erinjense/raspberrypi-indoor-air-quality-pcb/README.md

# zephyrus-iaq
Hardware and Software for an Indoor Air Quality Logger

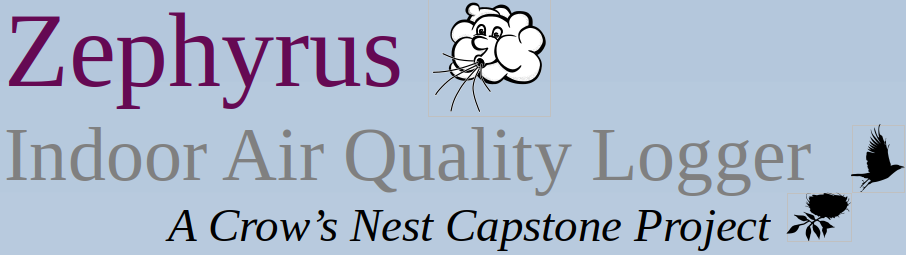
[picture p1: Software/images/Zephyrus-IAQ-Logo.png]

More to come...
