erinjense/raspberrypi-indoor-air-quality-pcb/Hardware/Pictures/Crows-Nest-CC.png

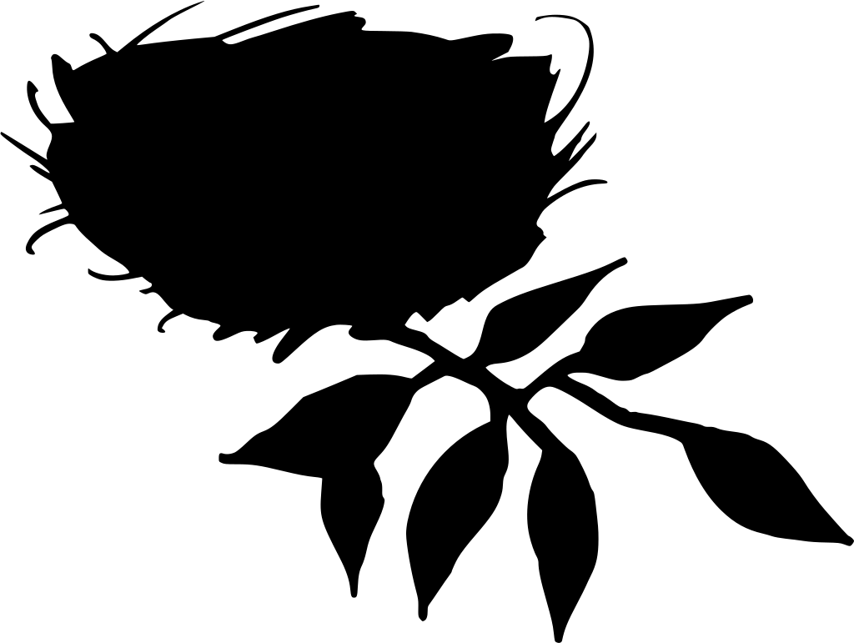
Hardware/Pictures/Crows-Nest-CC.png
