erinjense/raspberrypi-indoor-air-quality-pcb/Hardware/Pictures/Flying-Crow-CC.png

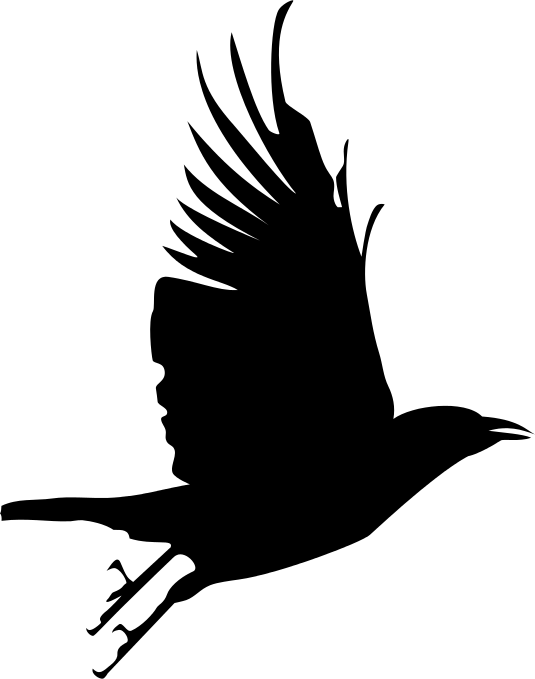
Hardware/Pictures/Flying-Crow-CC.png
