erinjense/raspberrypi-indoor-air-quality-pcb/Software/Config/logger_setup.csv

Logger Type | IAQ
Id | IAQ_0
Software Version | Alpha
Headers | Date(YYYY/MM/DD) | Time(HH:MM:SS) | Location(degrees) | Temp(C) | Humidity(RH)
Sensors | ./config/sensors/bme680.csv | ./config/sensors/mq_gas.csv
