erinjense/raspberrypi-indoor-air-quality-pcb/Hardware/Zephyrus-IAQ-HAT.pdf

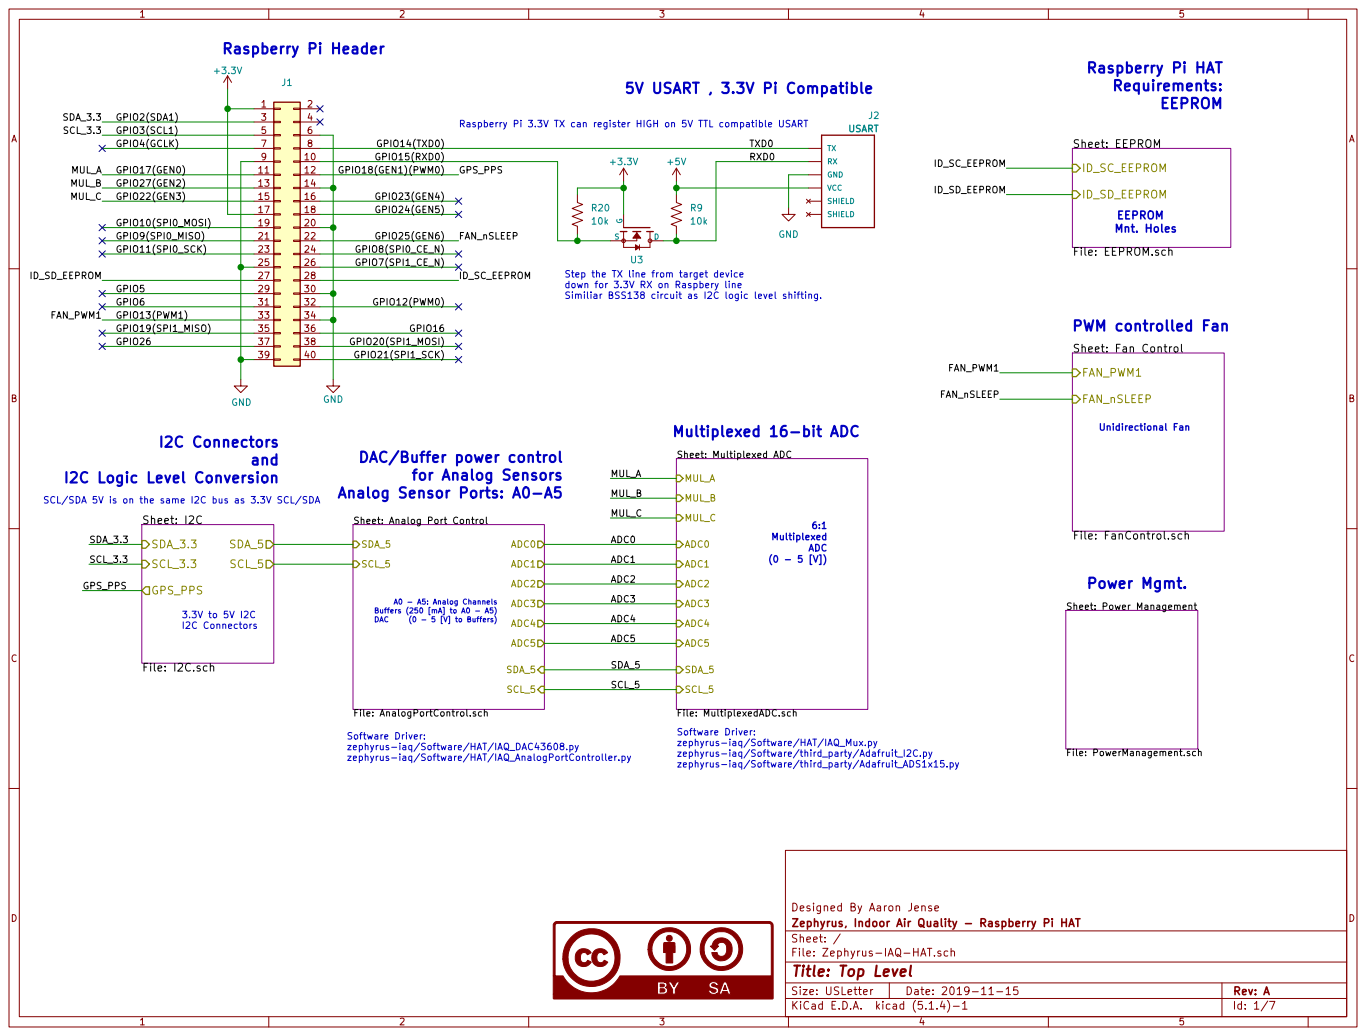
[picture p4: page 1]

Raspberry Pi 3.3V TX can register HIGH on 5V TTL compatible USART

9 | | 10 | GPIO15(RXD0)
11 | | 12 | GPIO18(GEN1)(PWM0)
13 | | 14 | GPIO23(GEN4)
15 | | 16
17 | | 18 | GPIO24(GEN5)
19 | | 20 | GPIO25(GEN6)
21 | | 22
23 | | 24
25 | | 26
27 | | 28
29 | | 30
31 | | 32
33 | | 34
35 | | 36
37 | | 38
39 | | 40

Step the TX line from target device
down for 3.3V RX on Raspbery line
File: MultiplexedADC.sch ADC0 ADC1 ADC2 ADC3 ADC4 ADC5 MUL_A MUL_B MUL_C

DAC/Buffer power control
for Analog Sensors

Designed By Aaron Jense Sheet: I2C

Sheet: Analog Port Control

Software Driver: zephyrus-iaq/Software/HAT/IAQ_Mux.py

zephyrus-iaq/Software/third_party/Adafruit_ADS1x15.py Software Driver: zephyrus-iaq/Software/HAT/IAQ_DAC43608.py

zephyrus-iaq/Software/HAT/IAQ_AnalogPortController.py

zephyrus-iaq/Software/third_party/Adafruit_I2C.py

File: Zephyrus-IAQ-HAT.sch Sheet: / Zephyrus, Indoor Air Quality - Raspberry Pi HAT

Id: 1/7 Title: Top Level

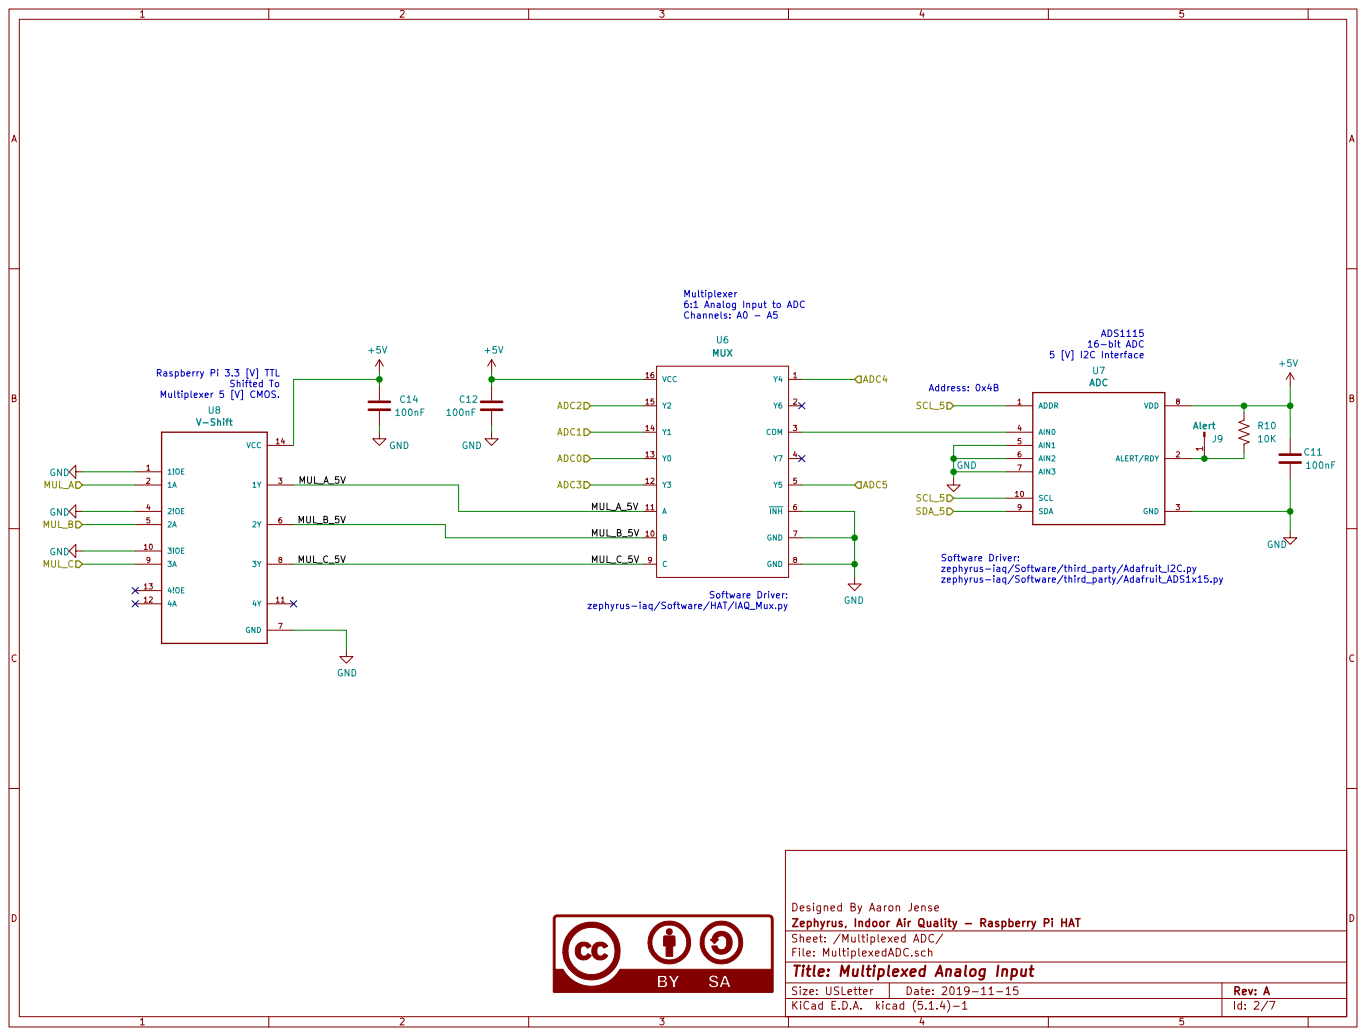
[picture p5: page 2]

Multiplexer
6:1 Analog Input to ADC

Channels: A0 - A5 Raspberry Pi 3.3 [V] TTL Shifted To

zephyrus-iaq/Software/third_party/Adafruit_ADS1x15.py Address: 0x4B

Designed By Aaron Jense
Zephyrus, Indoor Air Quality - Raspberry Pi HAT
Sheet: /Multiplexed ADC/
File: MultiplexedADC.sch
Id: 2/7 Title: Multiplexed Analog Input

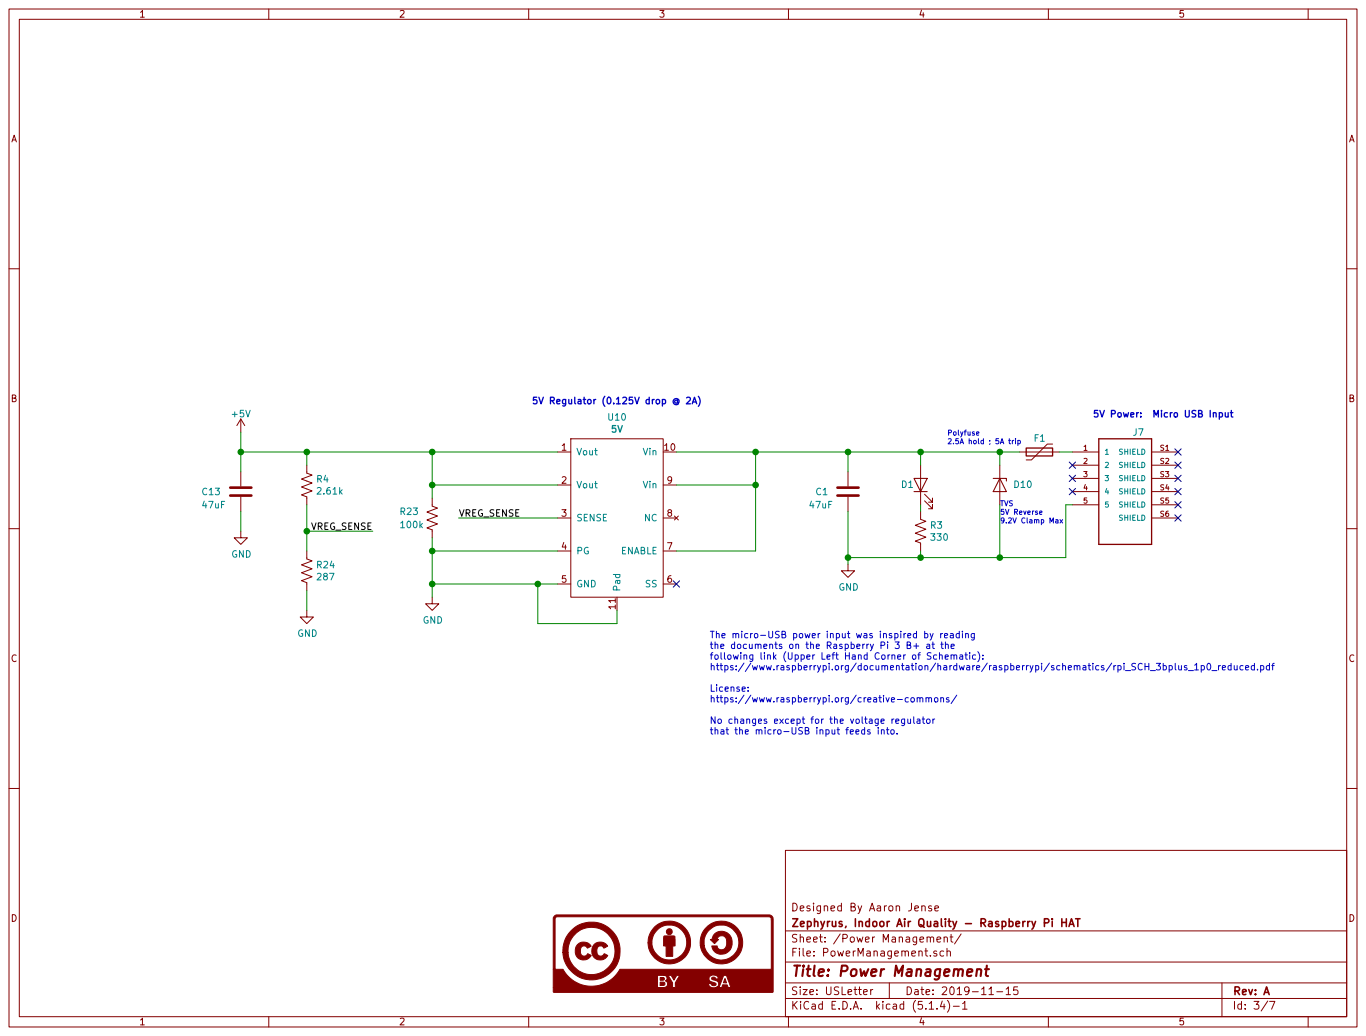
[picture p6: page 3]

2.5A hold ; 5A trip 5V Regulator (0.125V drop @ 2A)

5V Power: Micro USB Input TVS

The micro-USB power input was inspired by reading
the documents on the Raspberry Pi 3 B+ at the
following link (Upper Left Hand Corner of Schematic):
https://www.raspberrypi.org/documentation/hardware/raspberrypi/schematics/rpi_SCH_3bplus_1p0_reduced.pdf License: https://www.raspberrypi.org/creative-commons/

No changes except for the voltage regulator
that the micro-USB input feeds into.

Designed By Aaron Jense
Zephyrus, Indoor Air Quality - Raspberry Pi HAT
Sheet: /Power Management/
File: PowerManagement.sch
Id: 3/7 Title: Power Management

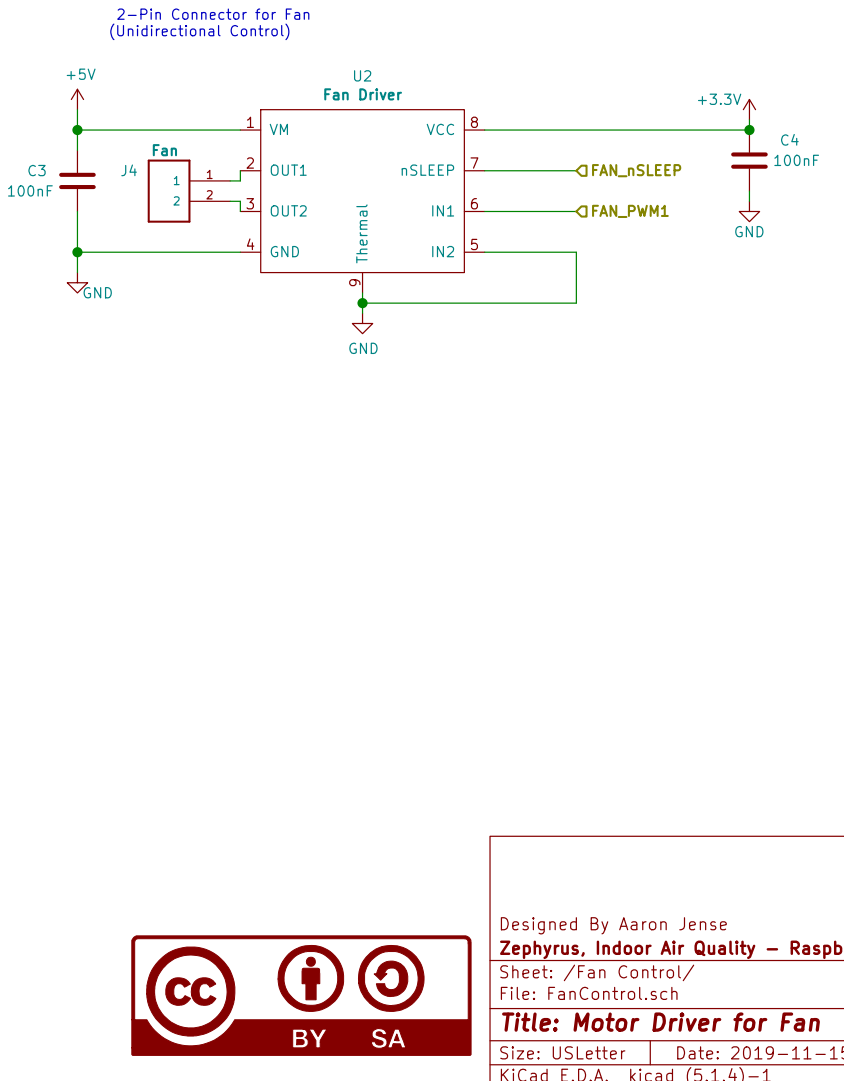
[picture p7: page 4]

2-Pin Connector for Fan
(Unidirectional Control)

Designed By Aaron Jense
File: FanControl.sch Sheet: /Fan Control/ Zephyrus, Indoor Air Quality - Raspberry Pi HAT

Id: 4/7 Title: Motor Driver for Fan

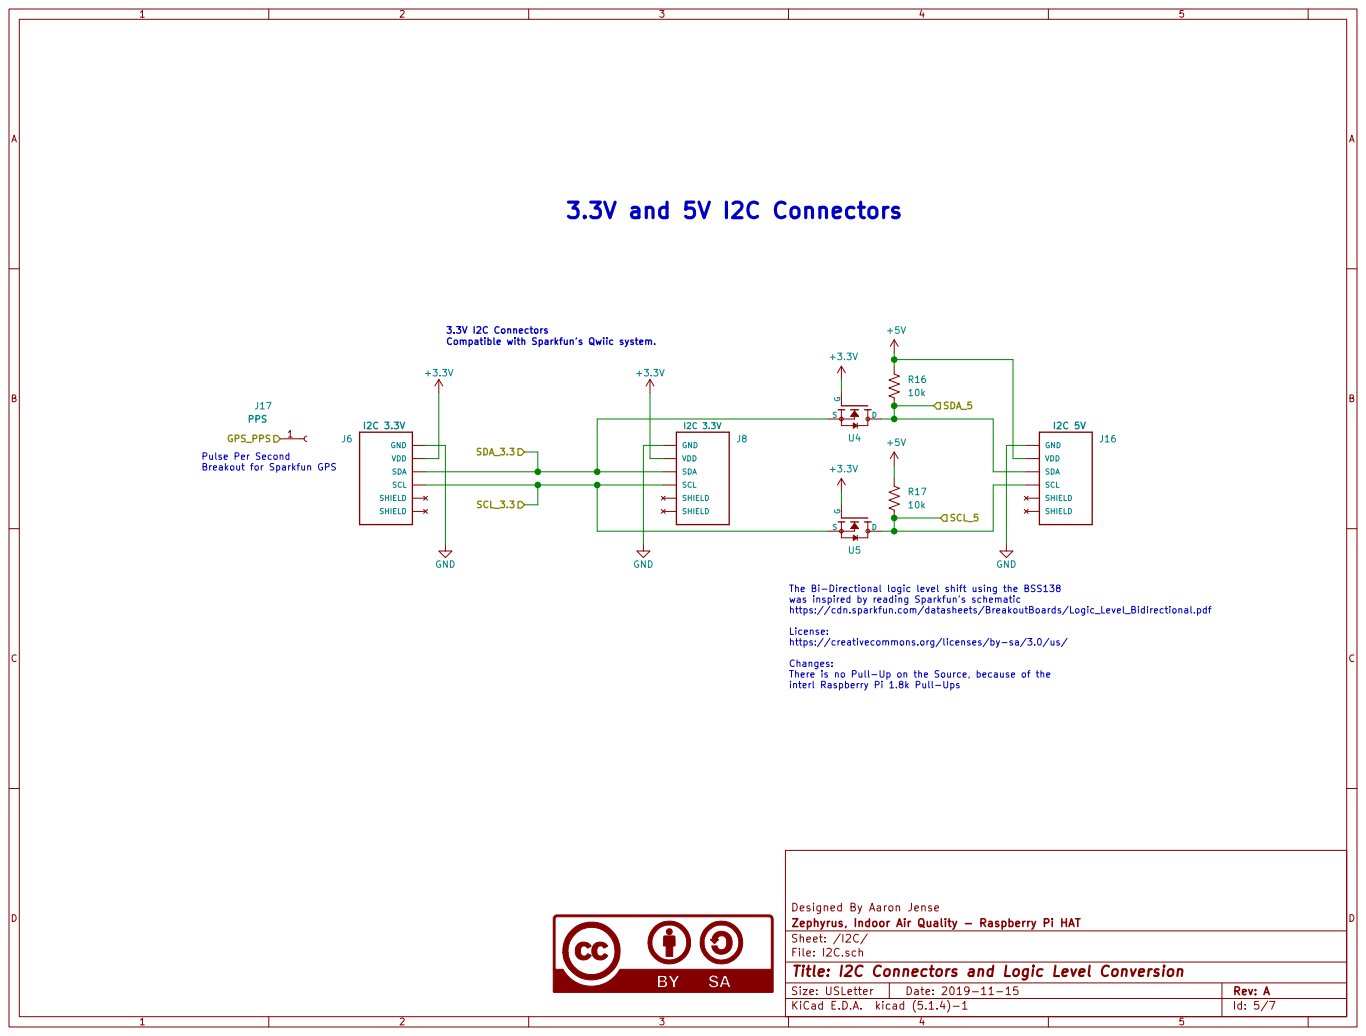
[picture p8: page 5]

interl Raspberry Pi 1.8k Pull-Ups 3.3V I2C Connectors Compatible with Sparkfun's Qwiic system.

SCL_3.3 SDA_3.3 Pulse Per Second Breakout for Sparkfun GPS

The Bi-Directional logic level shift using the BSS138
was inspired by reading Sparkfun's schematic
https://cdn.sparkfun.com/datasheets/BreakoutBoards/Logic_Level_Bidirectional.pdf License: https://creativecommons.org/licenses/by-sa/3.0/us/

Changes:
There is no Pull-Up on the Source, because of the

Designed By Aaron Jense
File: I2C.sch Sheet: /I2C/ Zephyrus, Indoor Air Quality - Raspberry Pi HAT

Id: 5/7 Title: I2C Connectors and Logic Level Conversion

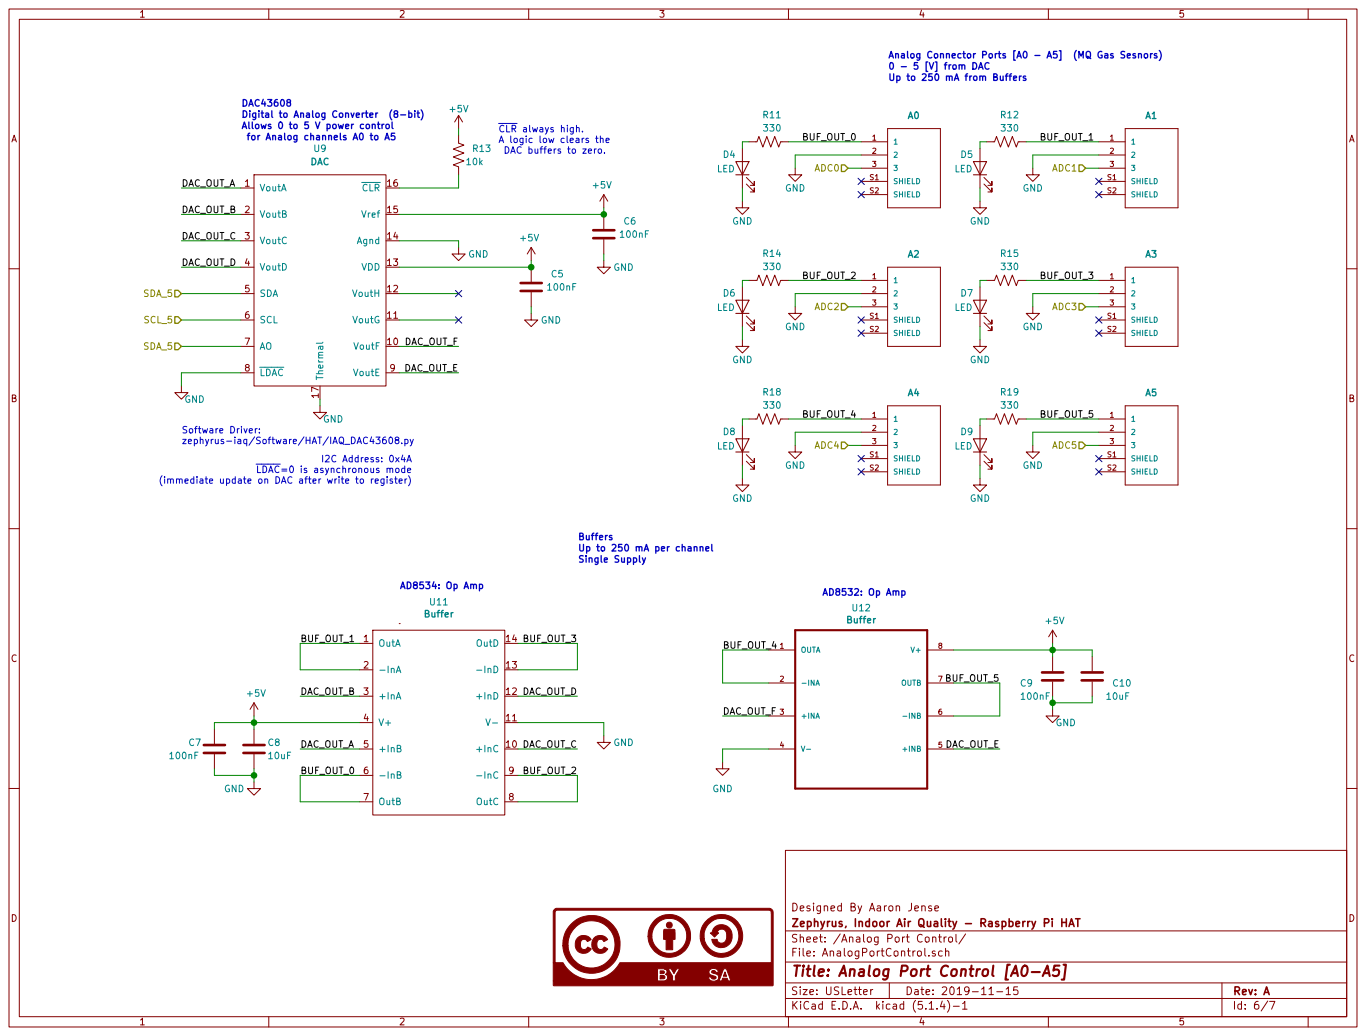
[picture p9: page 6]

Analog Connector Ports [A0 - A5] (MQ Gas Sesnors)
0 - 5 [V] from DAC

Up to 250 mA from Buffers DAC43608 Digital to Analog Converter (8-bit)

Allows 0 to 5 V power control
for Analog channels A0 to A5

CLR always high.
A logic low clears the

(immediate update on DAC after write to register)

LDAC=0 is asynchronous mode

Designed By Aaron Jense
Zephyrus, Indoor Air Quality - Raspberry Pi HAT
Sheet: /Analog Port Control/
File: AnalogPortControl.sch
Id: 6/7 Title: Analog Port Control [A0-A5]

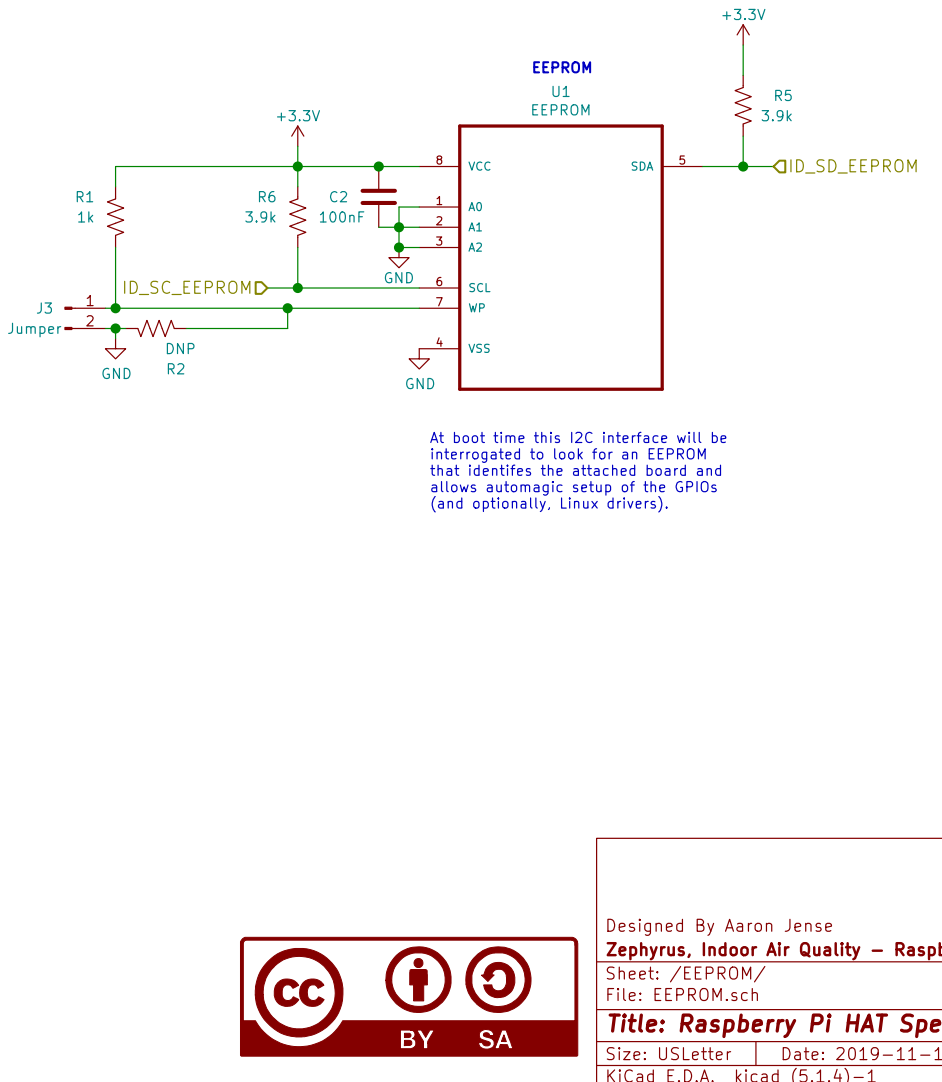
[picture p10: page 7]

Designed By Aaron Jense GND

At boot time this I2C interface will be
interrogated to look for an EEPROM
that identifes the attached board and
allows automagic setup of the GPIOs
(and optionally, Linux drivers).

File: EEPROM.sch Sheet: /EEPROM/ Zephyrus, Indoor Air Quality - Raspberry Pi HAT

Id: 7/7 Title: Raspberry Pi HAT Specifications
