erinjense/raspberrypi-indoor-air-quality-pcb/Hardware/Zephyrus-IAQ-HAT.kicad_pcb

## KiCad design Hardware/Zephyrus-IAQ-HAT.kicad_pcb (2019-12-04)

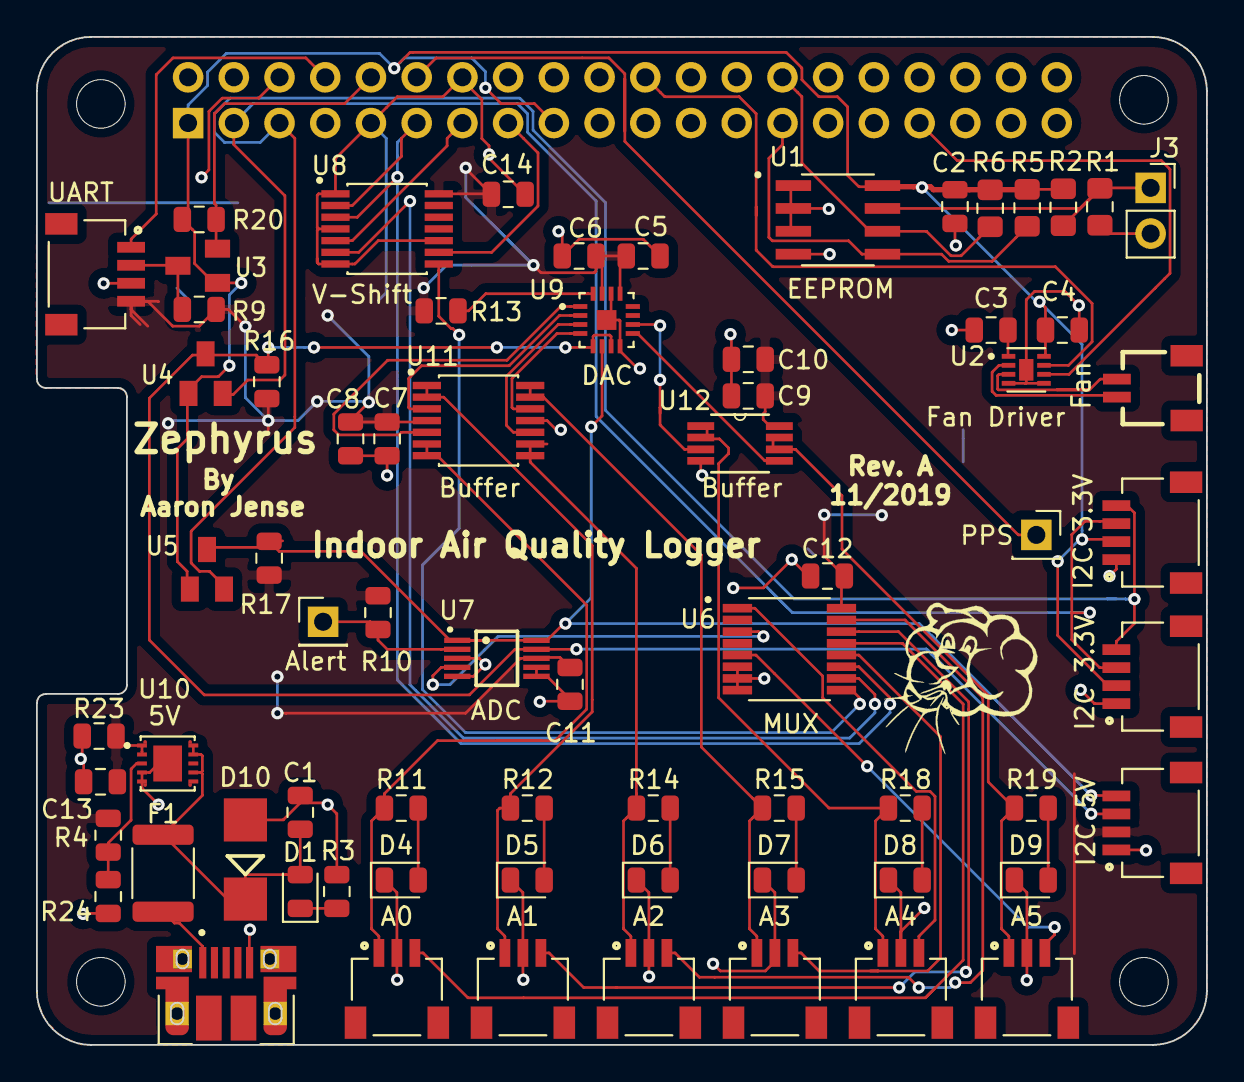
[picture p11: board Zephyrus-IAQ-HAT.kicad_pcb from above]

Board: 2 copper layers, 65.0 x 56.0 mm, 75 parts (1 on the bottom side), 55 nets.

Parts:
C1, C13: 47uF; C_0805_2012Metric
C2, C3, C4, C5, C6, C7, C9, C11, C12, C14: 100nF; C_0805_2012Metric
C8, C10: 10uF; C_0805_2012Metric
D1: PWR; D_0805_2012Metric
D4, D5, D6, D7, D8, D9: LED; D_0805_2012Metric
D10: SMBJ5.0A
F1: MF-MSMF250/X; Fuse_1812_4532Metric
J1: Conn_02x20_Odd_Even__Rpi; PinSocket_2x20_P2.54mm_Vertical
J2: UART; JST_SM04B-SRSS-TB(LF)(SN)
J3: Jumper; PinSocket_1x02_P2.54mm_Vertical
J4: Fan; SM02B-SRSS-TB(LF)(SN)
J6, J8: I2C 3.3V; JST_SM04B-SRSS-TB(LF)(SN)
J7: 10103594-0001LF; FCI_10103594-0001LF
J9: Alert; PinHeader_1x01_P2.54mm_Vertical
J10: A0; JST_SM03B-SRSS-TB(LF)(SN)
J11: A1; JST_SM03B-SRSS-TB(LF)(SN)
J12: A2; JST_SM03B-SRSS-TB(LF)(SN)
J13: A3; JST_SM03B-SRSS-TB(LF)(SN)
J14: A4; JST_SM03B-SRSS-TB(LF)(SN)
J15: A5; JST_SM03B-SRSS-TB(LF)(SN)
J16: I2C 5V; JST_SM04B-SRSS-TB(LF)(SN)
J17: PPS; PinSocket_1x01_P2.54mm_Vertical
MK1, MK2, MK3, MK4: M2.5; MountingHole_2.7mm_M2.5
R1: 1k; R_0805_2012Metric_Pad1.15x1.40mm_HandSolder
R2: DNP; R_0805_2012Metric_Pad1.15x1.40mm_HandSolder
R3, R11, R12, R14, R15, R18, R19: 330; R_0805_2012Metric
R4: 2.61k; R_0805_2012Metric
R5, R6: 3.9k; R_0805_2012Metric_Pad1.15x1.40mm_HandSolder
R9, R13, R16, R17, R20: 10k; R_0805_2012Metric
R10: 10K; R_0805_2012Metric
R23: 100k; R_0805_2012Metric
R24: 287; R_0805_2012Metric
U1: EEPROM; SOIC127P600X175-8N
U2: Fan Driver; SON50P200X200X80-9N
U3, U4, U5: BSS138
U6: MUX; SOP65P640X120-16N
U7: ADC; SOP50P490X110-10N
U8: V-Shift; SOP65P640X120-14N
U9: DAC; QFN50P300X300X80-17N
U10: 5V; REG_EY1501DI-ADJ
U11: Buffer; SOP65P640X120-14N
U12: Buffer; SOP65P490X110-8N

Connections:
+3V3: C2.1, C4.1, J1.1, J1.17, J6.2, J8.2, R1.1, R5.1, R6.1, R20.1, U1.8, U2.8, U3.G, U4.G, U5.G
+5V: C3.1, C5.1, C6.1, C7.1, C8.1, C9.1, C10.1, C11.1, C12.1, C13.1, C14.1, J2.4, J16.2, R4.1, R9.1, R10.1, R13.1, R16.1, R17.1, R23.1, U2.1, U6.16, U7.8, U8.14, U9.13, U9.15, U10.1, U10.2, U11.4, U12.8
/ADC0: J10.3, U6.13
/ADC1: J11.3, U6.14
/ADC2: J12.3, U6.15
/ADC3: J13.3, U6.12
/ADC4: J14.3, U6.1
/ADC5: J15.3, U6.5
/Analog Port Control/BUF_OUT_0: J10.1, R11.2, U11.6, U11.7
/Analog Port Control/BUF_OUT_1: J11.1, R12.2, U11.1, U11.2
/Analog Port Control/BUF_OUT_2: J12.1, R14.2, U11.8, U11.9
/Analog Port Control/BUF_OUT_3: J13.1, R15.2, U11.13, U11.14
/Analog Port Control/BUF_OUT_4: J14.1, R18.2, U12.1, U12.2
/Analog Port Control/BUF_OUT_5: J15.1, R19.2, U12.6, U12.7
/Analog Port Control/DAC_OUT_A: U9.1, U11.5
/Analog Port Control/DAC_OUT_B: U9.2, U11.3
/Analog Port Control/DAC_OUT_C: U9.3, U11.10
/Analog Port Control/DAC_OUT_D: U9.4, U11.12
/Analog Port Control/DAC_OUT_E: U9.9, U12.5
/Analog Port Control/DAC_OUT_F: U9.10, U12.3
/FAN_PWM1: J1.33, U2.6
/FAN_nSLEEP: J1.22, U2.7
/GPIO2(SDA1): J1.3, J6.3, J8.3, U4.S
/GPIO3(SCL1): J1.5, J6.4, J8.4, U5.S
/GPIO14(TXD0): J1.8, J2.1
/GPIO15(RXD0): J1.10, R20.2, U3.S
/GPIO17(GEN0): J1.11, U8.2
/GPIO18(GEN1)(PWM0): J1.12, J17.1
/GPIO22(GEN3): J1.15, U8.9
/GPIO27(GEN2): J1.13, U8.5
/ID_SC_EEPROM: J1.28, R6.2, U1.6
/ID_SD_EEPROM: J1.27, R5.2, U1.5
/Multiplexed ADC/MUL_A_5V: U6.11, U8.3
/Multiplexed ADC/MUL_B_5V: U6.10, U8.6
/Multiplexed ADC/MUL_C_5V: U6.9, U8.8
/Power Management/VREG_SENSE: R4.2, R24.1, U10.3
/RXD0: J2.2, R9.2, U3.D
/SCL_5: J16.4, R17.2, U5.D, U7.1, U7.10, U9.6
/SDA_5: J16.3, R16.2, U4.D, U7.9, U9.5, U9.7
GND: C1.2, C2.2, C3.2, C4.2, C5.2, C6.2, C7.2, C8.2, C9.2, C10.2, C11.2, C12.2, C13.2, C14.2, D4.1, D5.1, D6.1, D7.1, D8.1, D9.1, D10.2, J1.6, J1.9, J1.14, J1.20, J1.25, J1.30, J1.34, J1.39, J2.3, J3.2, J6.1, J7.5, J8.1, J10.2, J11.2, J12.2, J13.2, J14.2, J15.2, J16.1, R2.1, R3.2, R23.2, R24.2, U1.1, U1.2, U1.3, U1.4, U2.4, U2.5, U2.9, U6.6, U6.7, U6.8, U7.3, U7.5, U7.6, U7.7, U8.1, U8.4, U8.7, U8.10, U9.8, U9.14, U9.17, U10.4, U10.5, U10.11, U11.11, U12.4
unnamed: C1.1, D1.2, D10.1, F1.2, U10.7, U10.9, U10.10
unnamed: D1.1, R3.1
unnamed: D4.2, R11.1
unnamed: D5.2, R12.1
unnamed: D6.2, R14.1
unnamed: D7.2, R15.1
unnamed: D8.2, R18.1
unnamed: D9.2, R19.1
unnamed: F1.1, J7.1
unnamed: J3.1, R1.2, R2.2, U1.7
unnamed: J4.1, U2.2
unnamed: J4.2, U2.3
unnamed: J9.1, R10.2, U7.2
unnamed: R13.2, U9.16
unnamed: U6.3, U7.4
