erinjense/raspberrypi-indoor-air-quality-pcb/Hardware/rpi-hat.kicad_pcb

## KiCad design Hardware/rpi-hat.kicad_pcb (2019-10-22)

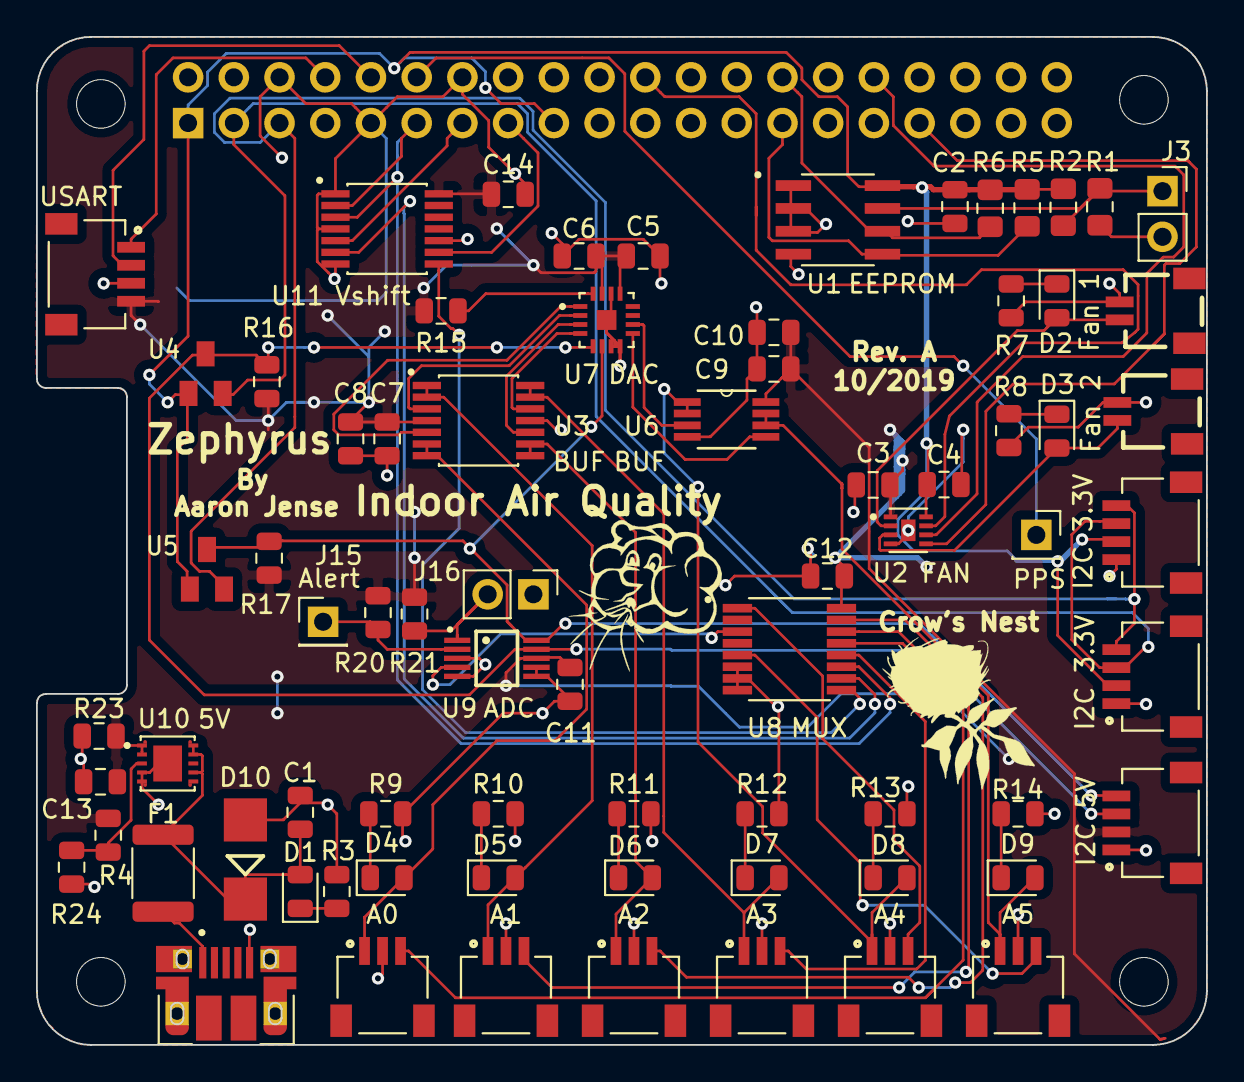
[picture p12: board rpi-hat.kicad_pcb from above]

Board: 2 copper layers, 65.0 x 56.0 mm, 79 parts (1 on the bottom side), 58 nets.

Parts:
C1, C13: 47uF; C_0805_2012Metric
C2, C3, C4, C5, C6, C7, C9, C11, C12, C14: 100nF; C_0805_2012Metric
C8, C10: 10uF; C_0805_2012Metric
D1: PWR; D_0805_2012Metric
D2, D3, D4, D5, D6, D7, D8, D9: LED; D_0805_2012Metric
D10: SMBJ5.0A
F1: MF-MSMF250/X; Fuse_1812_4532Metric
J1: Conn_02x20_Odd_Even__Rpi; PinSocket_2x20_P2.54mm_Vertical
J2: USART; JST_SM04B-SRSS-TB(LF)(SN)
J3: Jumper; PinSocket_1x02_P2.54mm_Vertical
J4: Fan 1; SM02B-SRSS-TB(LF)(SN)
J5: Fan 2; SM02B-SRSS-TB(LF)(SN)
J6, J8: I2C 3.3V; JST_SM04B-SRSS-TB(LF)(SN)
J7: 10103594-0001LF; FCI_10103594-0001LF
J9: A0; JST_SM03B-SRSS-TB(LF)(SN)
J10: A1; JST_SM03B-SRSS-TB(LF)(SN)
J11: A2; JST_SM03B-SRSS-TB(LF)(SN)
J12: A3; JST_SM03B-SRSS-TB(LF)(SN)
J13: A4; JST_SM03B-SRSS-TB(LF)(SN)
J14: A5; JST_SM03B-SRSS-TB(LF)(SN)
J15: Alert; PinHeader_1x01_P2.54mm_Vertical
J16: I2C 5V; JST_SM04B-SRSS-TB(LF)(SN)
J16#2: Conn_01x02_Male; PinHeader_1x02_P2.54mm_Vertical
J17: PPS; PinSocket_1x01_P2.54mm_Vertical
MK1, MK2, MK3, MK4: M2.5; MountingHole_2.7mm_M2.5
R1: 1k; R_0805_2012Metric_Pad1.15x1.40mm_HandSolder
R2: DNP; R_0805_2012Metric_Pad1.15x1.40mm_HandSolder
R3, R7, R8, R9, R10, R11, R12, R13, R14: 330; R_0805_2012Metric
R4: 2.61k; R_0805_2012Metric
R5, R6: 3.9k; R_0805_2012Metric_Pad1.15x1.40mm_HandSolder
R15: 10k; R_0805_2012Metric
R16, R17: 3.3k; R_0805_2012Metric
R20, R21: 10K; R_0805_2012Metric
R23: 100k; R_0805_2012Metric
R24: 287; R_0805_2012Metric
U1: EEPROM; SOIC127P600X175-8N
U2: FAN; SON50P200X200X80-9N
U3: BUF; SOP65P640X120-14N
U4, U5: BSS138
U6: BUF; SOP65P490X110-8N
U7: DAC; QFN50P300X300X80-17N
U8: MUX; SOP65P640X120-16N
U9: ADC; SOP50P490X110-10N
U10: 5V; REG_EY1501DI-ADJ
U11: Vshift; SOP65P640X120-14N

Connections:
+3V3: C2.1, C4.1, J1.1, J1.17, J6.2, J8.2, R1.1, R5.1, R6.1, U1.8, U2.8, U4.G, U5.G
+5V: C3.1, C5.1, C6.1, C7.1, C8.1, C9.1, C10.1, C11.1, C12.1, C13.1, C14.1, J2.4, J16.2, R4.1, R15.1, R16.1, R17.1, R20.1, R21.1, R23.1, U2.1, U3.4, U6.8, U7.13, U7.15, U8.16, U9.8, U10.1, U10.2, U11.14
/ADC0: J9.3, U8.13
/ADC1: J10.3, U8.14
/ADC2: J11.3, U8.15
/ADC3: J12.3, U8.12
/ADC4: J13.3, U8.1
/ADC5: J14.3, U8.5
/ADC_Subsystem/ADC_ADDR: J16#2.2, R21.2, U9.1
/ADC_Subsystem/ADC_ALERT: J15.1, R20.2, U9.2
/ADC_Subsystem/MUL_A_5V: U8.11, U11.3
/ADC_Subsystem/MUL_B_5V: U8.10, U11.6
/ADC_Subsystem/MUL_COM: U8.3, U9.4
/ADC_Subsystem/MUL_C_5V: U8.9, U11.8
/Analog_Sensors/BUF_OUT_0: D4.2, J9.1, U3.6, U3.7
/Analog_Sensors/BUF_OUT_1: D5.2, J10.1, U3.1, U3.2
/Analog_Sensors/BUF_OUT_2: D6.2, J11.1, U3.8, U3.9
/Analog_Sensors/BUF_OUT_3: D7.2, J12.1, U3.13, U3.14
/Analog_Sensors/BUF_OUT_4: D8.2, J13.1, U6.1, U6.2
/Analog_Sensors/BUF_OUT_5: D9.2, J14.1, U6.6, U6.7
/Analog_Sensors/DAC_CLR: R15.2, U7.16
/Analog_Sensors/DAC_OUT_A: U3.5, U7.1
/Analog_Sensors/DAC_OUT_B: U3.3, U7.2
/Analog_Sensors/DAC_OUT_C: U3.10, U7.3
/Analog_Sensors/DAC_OUT_D: U3.12, U7.4
/Analog_Sensors/DAC_OUT_E: U6.5, U7.9
/Analog_Sensors/DAC_OUT_F: U6.3, U7.10
/FAN_PWM0: J1.32, U2.6
/FAN_PWM1: J1.33, U2.5
/FAN_nSLEEP: J1.22, U2.7
/Fan_Control/FAN_OUT1: D2.2, J4.1, U2.2
/Fan_Control/FAN_OUT2: D3.2, J5.1, U2.3
/GPIO2(SDA1): J1.3, J6.3, J8.3, U4.S
/GPIO3(SCL1): J1.5, J6.4, J8.4, U5.S
/GPIO14(TXD0): J1.8, J2.1
/GPIO15(RXD0): J1.10, J2.2
/GPIO17(GEN0): J1.11, U11.2
/GPIO18(GEN1)(PWM0): J1.12, J17.1
/GPIO22(GEN3): J1.15, U11.9
/GPIO27(GEN2): J1.13, U11.5
/ID_SC_EEPROM: J1.28, R6.2, U1.6
/ID_SD_EEPROM: J1.27, R5.2, U1.5
/PowerManagement/VREG_IN_5V: C1.1, D1.2, D10.1, F1.2, U10.7, U10.9, U10.10
/PowerManagement/VREG_SENSE: R4.2, R24.1, U10.3
/SCL_5: J16.4, R17.2, U5.D, U7.6, U9.10
/SDA_5: J16.3, R16.2, U4.D, U7.5, U9.9
GND: C1.2, C2.2, C3.2, C4.2, C5.2, C6.2, C7.2, C8.2, C9.2, C10.2, C11.2, C12.2, C13.2, C14.2, D10.2, J1.6, J1.9, J1.14, J1.20, J1.25, J1.30, J1.34, J1.39, J2.3, J3.2, J4.2, J5.2, J6.1, J7.5, J8.1, J9.2, J10.2, J11.2, J12.2, J13.2, J14.2, J16.1, J16#2.1, R2.1, R3.2, R7.2, R8.2, R9.2, R10.2, R11.2, R12.2, R13.2, R14.2, R23.2, R24.2, U1.1, U1.2, U1.3, U1.4, U2.4, U2.9, U3.11, U6.4, U7.7, U7.8, U7.14, U7.17, U8.6, U8.7, U8.8, U9.3, U9.5, U9.6, U9.7, U10.4, U10.5, U10.11, U11.1, U11.4, U11.7, U11.10
unnamed: D1.1, R3.1
unnamed: D2.1, R7.1
unnamed: D3.1, R8.1
unnamed: D4.1, R9.1
unnamed: D5.1, R10.1
unnamed: D6.1, R11.1
unnamed: D7.1, R12.1
unnamed: D8.1, R13.1
unnamed: D9.1, R14.1
unnamed: F1.1, J7.1
unnamed: J3.1, R1.2, R2.2, U1.7
