erinjense/raspberrypi-indoor-air-quality-pcb/Software/HAT/IAQ_DAC43608.py

#!/usr/bin/python

#################################################################################
# MIT License
#
# Copyright (c) 2019 Aaron Jense, Amy Heidner, Dennis Heidner
#
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
# THE SOFTWARE IS PROVIDED "AS IS", WITHOUT WARRANTY OF ANY KIND, EXPRESS OR
# IMPLIED, INCLUDING BUT NOT LIMITED TO THE WARRANTIES OF MERCHANTABILITY,
# FITNESS FOR A PARTICULAR PURPOSE AND NONINFRINGEMENT. IN NO EVENT SHALL THE
# AUTHORS OR COPYRIGHT HOLDERS BE LIABLE FOR ANY CLAIM, DAMAGES OR OTHER
# LIABILITY, WHETHER IN AN ACTION OF CONTRACT, TORT OR OTHERWISE, ARISING FROM,
# OUT OF OR IN CONNECTION WITH THE SOFTWARE OR THE USE OR OTHER DEALINGS IN THE
# SOFTWARE.
#################################################################################

import time
import smbus
from third_party.Adafruit_I2C import *

# Standard mode (100 kbps)
# Fast mode (400 kbps)
# Fast+ mode (1.0 Mbps)
#
# +-----+-----+-----+-----+-----+-----+-----+-----+-----+-----+-----+-----+-----+-----+-----+-----+
# | MSB | ... | LSB | ACK | MSB | ... | LSB | ACK | MSB | ... | LSB | ACK | MSB | ... | LSB | ACK |
# +-----+-----+-----+-----+-----+-----+-----+-----+-----+-----+-----+-----+-----+-----+-----+-----+
# | Address (byte)  |     | Command byte    |     | MSDB            |     | LSDB            |     |
# +-----------------+-----+-----------------+-----+-----------------+-----+-----------------+-----+
# | DB [32:24]      |     | DB [23:16]      |     | DB [15:8]       |     | DB [7:0]        |     |
# +-----------------+-----+-----------------+-----+-----------------+-----+-----------------+-----+
#

# Vout = (DACn_DATA / (2^N)) * Vref
#   N = resolution in bits (8 for DAC43608)
#   DACn_DATA decimal equivalent to binary code loaded into DAC reg
#   DACn_DATA ranges from 0 to 2^N - 1


# CLR / LDAC not on Zephyrus IAQ rev a

# DAC43608 Data Byte (MSDB and LSDB)

# DACn_DATA Register Field
# B15 - B12 Don't Care
# B11 - B2  DACn_DATA[7:0]
#  B1 - B0  Don't Care

class DAC43608:

    i2c = None

    # DAC43608 Command Byte
    # Controls which command is executed and which is being accessed.
    # TI 8.5.4 pg 27
    # Byte:   B23 - B16
    __DAC43608_DEVICE_CONFIG = 1
    __DAC43608_STATUS        = 2
    __DAC43608_BRDCAST       = 3
    __DAC43608_DACA_DATA     = 8
    __DAC43608_DACB_DATA     = 9
    __DAC43608_DACC_DATA     = 10
    __DAC43608_DACD_DATA     = 11
    __DAC43608_DACE_DATA     = 12
    __DAC43608_DACF_DATA     = 13
    __DAC43608_DACG_DATA     = 14
    __DAC43608_DACH_DATA     = 15

    chA = None
    chB = None
    chC = None
    chD = None
    chE = None
    chF = None

    def __init__(self, address=0x48,debug=None):
        self.i2c = Adafruit_I2C(address,debug=False)
        self.address = address
        self.debug = debug

        self.chA = 0
        self.chB = 0
        self.chC = 0
        self.chD = 0
        self.chE = 0
        self.chF = 0

    def writeDac(self, command, data_16bits):
        self.i2c.write16(command, data_16bits)
        return

    def writeConfig(self,config_byte):
        self.writeDac(self.__DAC43608_DEVICE_CONFIG, config_byte)
        return

    def writeDacA(self, DACn_DATA):
        self.chA = DACn_DATA
        self.writeDac(self.__DAC43608_DACA_DATA, self.chA)
        return

    def writeDacB(self, DACn_DATA):
        self.chB = DACn_DATA
        self.writeDac(self.__DAC43608_DACB_DATA, self.chB)
        return

    def writeDacC(self, DACn_DATA):
        self.chC = DACn_DATA
        self.writeDac(self.__DAC43608_DACC_DATA, self.chC)
        return

    def writeDacD(self, DACn_DATA):
        self.chD = DACn_DATA
        self.writeDac(self.__DAC43608_DACD_DATA, self.chD)
        return

    def writeDacE(self, DACn_DATA):
        self.chE = DACn_DATA
        self.writeDac(self.__DAC43608_DACE_DATA, self.chE)
        return

    def writeDacF(self, DACn_DATA):
        self.chF = DACn_DATA
        self.writeDac(self.__DAC43608_DACF_DATA, self.chF)
        return
