erinjense/raspberrypi-indoor-air-quality-pcb/(commit log)

2019-03-22 Allow test configuration csv to be tracked for now
    [bme680.csv, csv_headers.csv, logger_setup.csv, mq_gas.csv]
2019-03-31 Simplified configuration
    [csv_headers.csv, logger_setup.csv]
2019-04-13 Add Telaire 6004 CO2 Symbol for KiCad
2019-04-13 Initial KiCad Schematic/Layout for Raspberry Pi Breakout. EEPROM added later for Hat spec.
    [rpi-hat.kicad_pcb, rpi-hat.sch]
2019-04-13 Temporary libraries until Raspberry Pi Breakout Template parts are updated.
2019-04-13 Add KiCad Symbol for Qwiic GPS
2019-04-13 Add KiCad Symbol for Sharp GP2Y1010.
    [rpi-hat.sch]
2019-04-20 Most functionality added. EEPROM for HAT spec, various JST connectors for sensors, ADC subsystem and power subsystem
    [rpi-hat.sch]
2019-04-21 Begin layout
    [rpi-hat.kicad_pcb, rpi-hat.sch]
2019-10-01 New HAT features.
    [ADC_Subsystem.sch, Analog_Sensors.sch, rpi-hat.kicad_pcb]
2019-10-01 Update footprint library
2019-10-01 Clean Up KiCad Library
    [ADC_Subsystem.sch, Analog_Sensors.sch, rpi-hat.kicad_pcb, rpi-hat.sch]
2019-10-01 KiCad Library Cleanup.
2019-10-02 DRC passing changes. Proper pin identifiers.
    Need to swap SN74LVC1G3157 for a power multiplexor IC.
    [ADC_Subsystem.sch, Analog_Sensors.sch, rpi-hat.sch]
2019-10-07 Update Schematic/Layout
    [ADC_Subsystem.sch, Analog_Sensors.sch, rpi-hat.kicad_pcb, rpi-hat.sch]
2019-10-07 Update KiCad Layout
    [rpi-hat.kicad_pcb, rpi-hat.sch]
2019-10-07 KiCad Layout Update
    [Analog_Sensors.sch, rpi-hat.kicad_pcb]
2019-10-07 PCB Complete. Pending Review.
    [Analog_Sensors.sch, rpi-hat.kicad_pcb, rpi-hat.sch]
2019-10-09 Add Voltage Regulator. Update traces.
    [ADC_Subsystem.sch, Analog_Sensors.sch, PowerManagement.sch, rpi-hat.kicad_pcb, rpi-hat.sch]
2019-10-09 Update PCB Logo
    [rpi-hat.kicad_pcb]
2019-10-09 Fixed EEPROM I2C. Removed uneeded pull up resistors.
    Rpi has internal pull ups.
    [Analog_Sensors.sch, rpi-hat.kicad_pcb, rpi-hat.sch]
2019-10-10 Added Level Shifter for Multiplexer
    [ADC_Subsystem.sch, Analog_Sensors.sch, PowerManagement.sch, rpi-hat.kicad_pcb, rpi-hat.sch]
2019-10-14 Updated Schematic and Layout
    Created a schematic sheet for each subsystem.
    Fixed INH on MUX being wrongly tied to an enable pin.
    INH: GND (Always output Y0-Y5/A0-A5 on MUX)
    Fixed SDA/SCL mix-up on 3.3V I2C Connector.
    [ADC_Subsystem.sch, Analog_Sensors.sch, Fan_Control.sch, HAT_Spec.sch, I2C.sch, PowerManagement.sch, rpi-hat.kicad_pcb, rpi-hat.sch]
2019-10-14 Schematic Cleanup
    [Analog_Sensors.sch, I2C.sch, rpi-hat.sch]
2019-10-15 Update I2C netlist and footprint association
    [ADC_Subsystem.sch, Analog_Sensors.sch, I2C.sch, rpi-hat.sch]
2019-10-15 Update Footprint association for EEPROM
    [HAT_Spec.sch]
2019-10-15 Fix EEPROM SD and SC lines
    [Fan_Control.sch, HAT_Spec.sch]
2019-10-17 Add Adafruit I2C code
2019-10-18 Update PCB
    [rpi-hat.kicad_pcb]
2019-10-20 Change Buffer footprint.
    [Analog_Sensors.sch, rpi-hat.kicad_pcb]
2019-10-20 Update silk screen
    [rpi-hat.kicad_pcb]
2019-10-20 Update I2C Documentation
    [I2C.sch, PowerManagement.sch]
2019-10-22 Hardware changes for PCB order 1
    [rpi-hat.kicad_pcb]
2019-10-22 Reorganized directory layout
    [ADC_Subsystem.sch, Analog_Sensors.sch, Fan_Control.sch, HAT_Spec.sch, I2C.sch, PowerManagement.sch, bme680.csv, logger_setup.csv]
2019-10-22 Add MQ gas sensor reading test app
2019-10-28 Add functionality for MQ Gas Sensors
2019-11-03 Project Directory Formatting
    [bme680.csv, logger_setup.csv, mq_gas.csv]
2019-11-03 Add Button naming from list
2019-11-03 Simplify sensor frames into one SensorView Class
2019-11-03 Add Logger class to IAQ_Logger Update Config files Change some name schemes
    [bme680.csv, logger_setup.csv, mq_gas.csv]
2019-11-04 SDS011 Particulate Sensor Initial Code
2019-11-05 Connected MqGas Sensors from inside Logger to AnalogPortController.
2019-11-06 Add exceptions for when no sensors are connected.
2019-11-10 Rudimentry SQLite Support Support for creating a default SQLite database The database contains a Sensors table with setup info. for each MQ gas sensor. The database contains a data storage table for 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
2019-11-10 Select MQ Sensors can now log their data to their own database
2019-11-10 Added Port:Sensor dictionary to keep track of which sensors are on or off
2019-11-10 Add features for GUI and AnalogPortController GUI won't create SensorView for sensors that are turned off GUI will rename default button names from [A0-A5] to their assigned sensor or keep default if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
2019-11-11 Update GUI. Groundwork for having multiple sensor views depending if sensor is setup or not.
2019-11-12 GUI Features Created StartPage update for each analog button name and color
2019-11-12 Changed how the portStatus dictionary is created from the sensor setup database GUI is now initialized based off of the portStatus dictionary from database and not hard-coded values
2019-11-16 Organized Schematic Naming and Added Comments
    [AnalogPortControl.sch, EEPROM.sch, FanControl.sch, Fan_Control.sch, HAT_Spec.sch, I2C.sch, MultiplexedADC.sch, PowerManagement.sch]
2019-11-16 Organized schematic naming
    [Zephyrus-IAQ-HAT.kicad_pcb]
2019-11-18 Up Changed I2C addres for DAC and ADC. Added MOSFET to USART RX.
    [AnalogPortControl.sch, EEPROM.sch, FanControl.sch, I2C.sch, MultiplexedADC.sch, PowerManagement.sch, Zephyrus-IAQ-HAT.sch]
2019-11-19 Updated Schematic Attribution and Documentation
    [AnalogPortControl.sch, EEPROM.sch, FanControl.sch, I2C.sch, MultiplexedADC.sch, PowerManagement.sch, Zephyrus-IAQ-HAT.sch]
2019-11-19 Updated schematic library location
    [AnalogPortControl.sch, EEPROM.sch, FanControl.sch, I2C.sch, MultiplexedADC.sch, PowerManagement.sch, Zephyrus-IAQ-HAT.sch]
2019-11-19 Exported Schematic as PDF
2019-11-19 Add Pull-Up to UART line.
    [Zephyrus-IAQ-HAT.sch]
2019-11-19 Begin GUI Overhaul. Changed GUI button names, and general layout
2019-11-19 Update PCB to latest schematic changes.
    [I2C.sch, Zephyrus-IAQ-HAT.kicad_pcb, Zephyrus-IAQ-HAT.sch]
2019-11-20 Update footprint for AD8532, traces, and back silkscreen.
    [AnalogPortControl.sch, Zephyrus-IAQ-HAT.kicad_pcb]
2019-11-21 Fix fan control.
    [FanControl.sch, Zephyrus-IAQ-HAT.kicad_pcb, Zephyrus-IAQ-HAT.sch]
2019-11-23 Add dedicated USB Port setup script
    [bme680.csv, logger_setup.csv, mq_gas.csv]
2019-11-24 Add GUI buttons for turning logger On/Off and mounting/ejecting USB
2019-11-24 Match /dev/disk/by-path to Raspberry Pi 3 B+ (was Raspberry Pi 3 B)
2019-11-25 Integration of USB mount/eject with GUI
2019-11-25 Simplify checking if USB is attached
2019-11-27 Simplify sensor setup, add SCD30, BME680 and SDS011 to CSV logging
2019-11-27 Change timers in IAQ_LOGGER
2019-11-28 Add formatted data output for each sensor to GUI. Change ADC gain.
2019-11-28 Add Settings Button
2019-11-29 Changes for sensor setup edge cases
2019-12-01 Fix bugs: 1.) IAQ_Config: Moved Humidity and Pressure locations to match data order. 2.) usb-port-setup.sh: Made sure to chown /media/zephyrus-iaq-usb for pi. 3.) IAQ_BME680: Except IOError from I2C.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
    [IAQ_BME680.py]
2019-12-03 Add last two analog ports to AnalogPortController. Add SDS011 read error.
    [IAQ_DAC43608.py, IAQ_SDS011.py]
2019-12-04 Add 3D footprints from SnapEDA
    Hardware/Pictures are Creative Commons.
    KiCad schematic symbols, 2D footprints, and 3D footprints from SnapEDA or KiCad Library.
    [Zephyrus-IAQ-HAT.kicad_pcb]
2019-12-04 AD8532ARMZ Footprint change.
    [AnalogPortControl.sch, Zephyrus-IAQ-HAT.kicad_pcb]
2019-12-04 Add On/Off status to sensor config. Changed SDS011 units
